NidhiLohana/RocketTeam/RU First Prototype/STM 32 RU First Prototype.kicad_pcb

## KiCad design RU First Prototype/STM 32 RU First Prototype.kicad_pcb (2026-11-07)

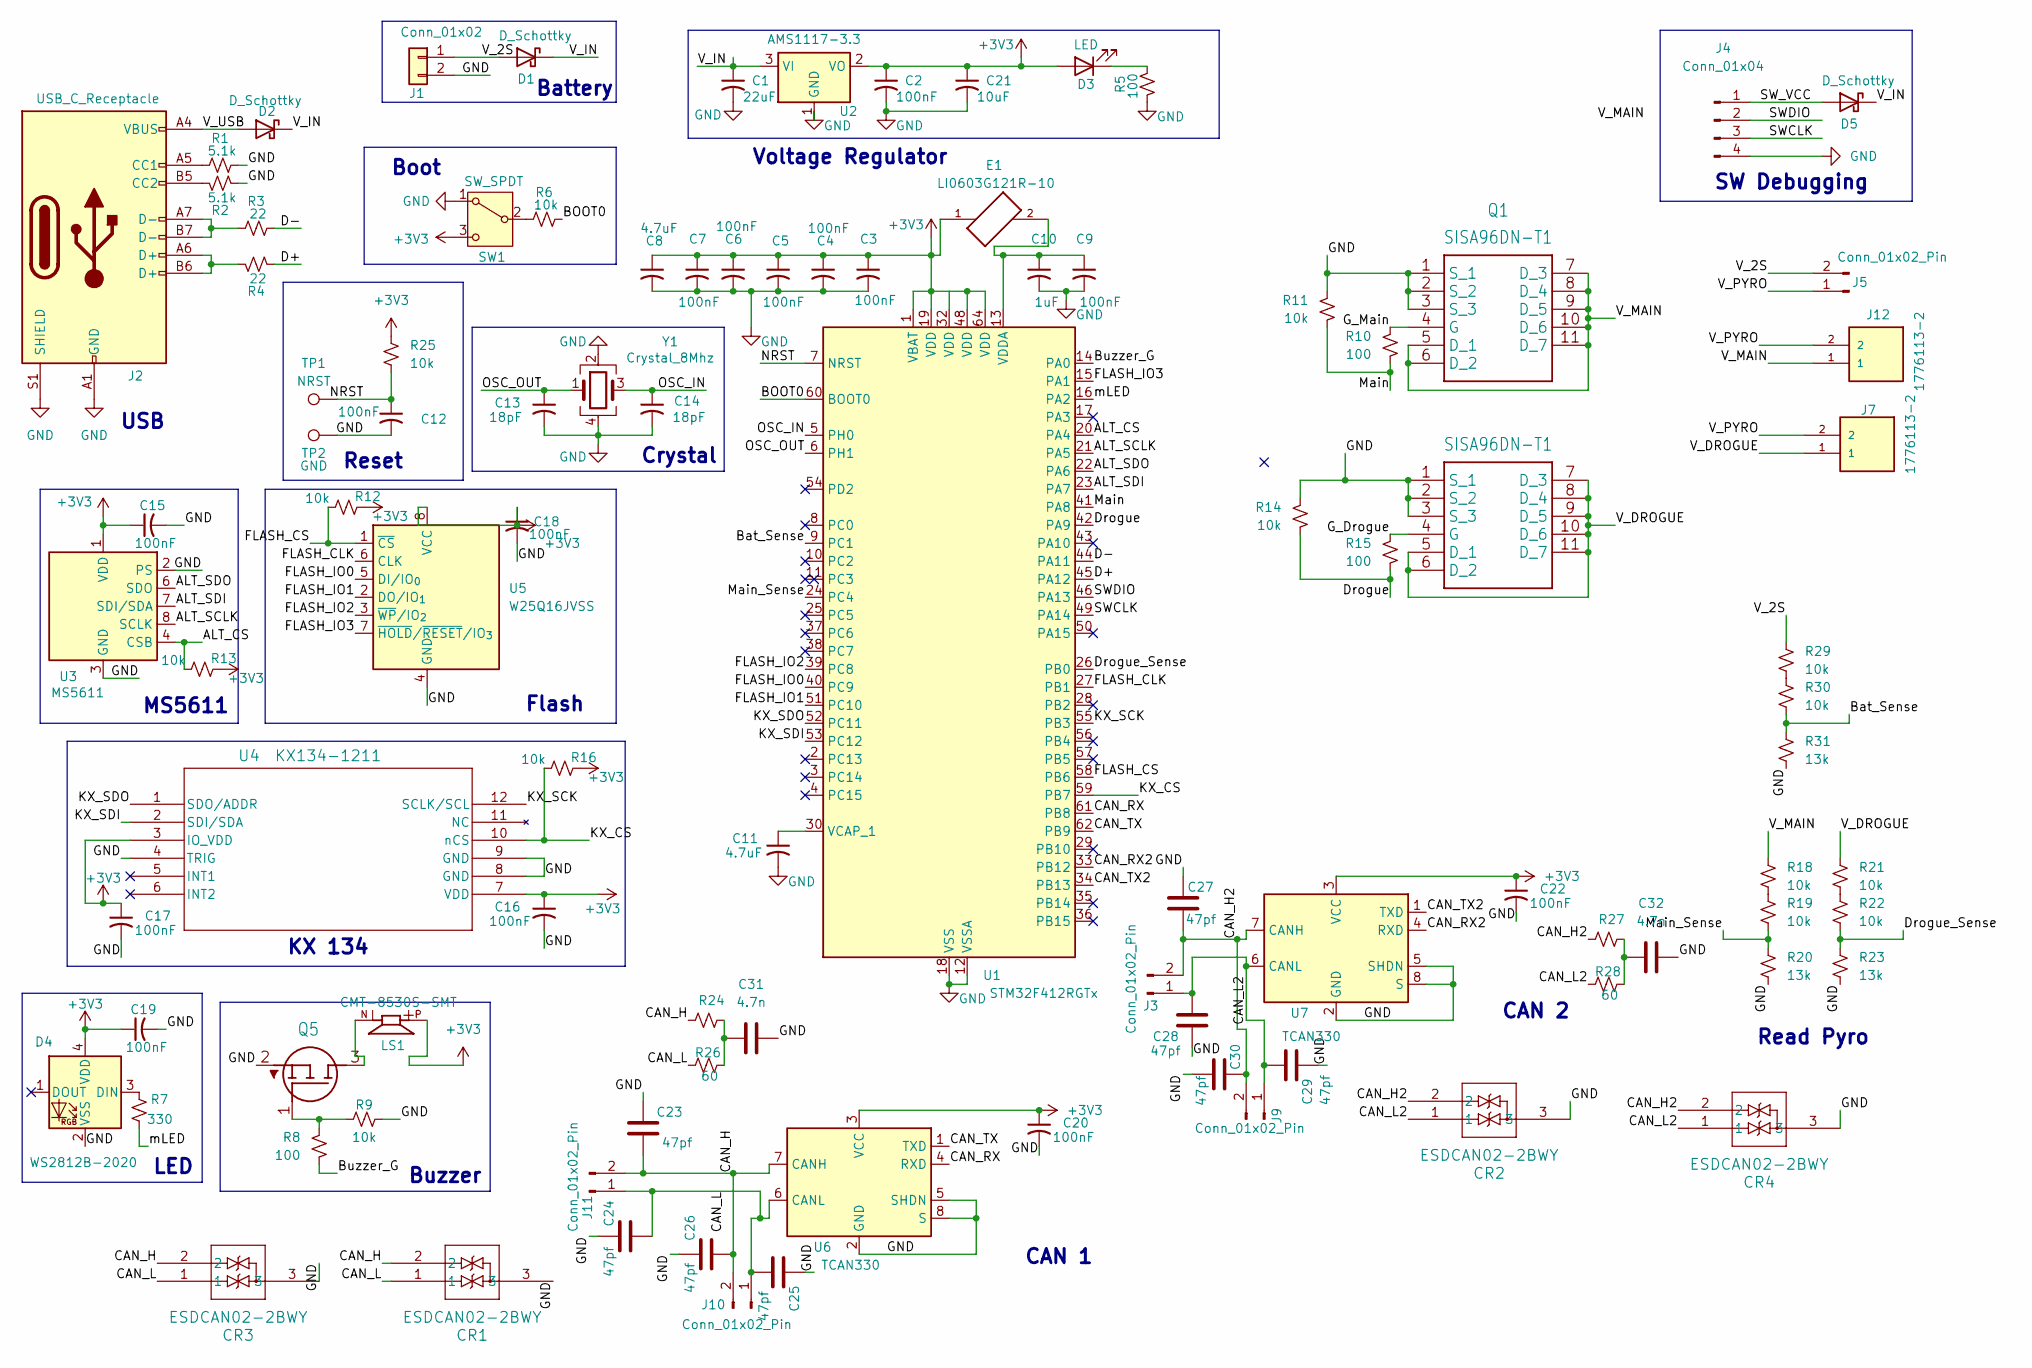
[picture p1: schematic STM 32 RU First Prototype.kicad_sch]

Parts:
C1: 22uF; C_0603_1608Metric
C2, C3, C4, C5, C6, C7, C9, C12, C15, C16, C17, C18, C19, C20, C22: 100nF; C_0603_1608Metric
C8, C11: 4.7uF; C_0603_1608Metric
C10: 1uF; C_0603_1608Metric
C13, C14: 18pF; C_0603_1608Metric
C21: 10uF; C_0603_1608Metric
C23, C24, C25, C26, C27, C28, C29, C30: 47pf; C_0603_1608Metric
C31, C32: 4.7n; C_0603_1608Metric
CR1, CR2, CR3, CR4: ESDCAN02-2BWY; SOT323-3L_STM
D1, D2, D5: D_Schottky; D_SOD-128
D3: LED; D_0603_1608Metric
D4: WS2812B-2020; LED_WS2812B-2020_PLCC4_2.0x2.0mm
E1: LI0603G121R-10; FB_LI0603G121R-10; PARTREV C
J1: Conn_01x02; AMASS_XT30U-M_1x02_P5.0mm_Vertical
J2: USB_C_Receptacle; USB_C_Receptacle_GCT_USB4105-xx-A_16P_TopMnt_Horizontal
J3, J9, J10, J11: Conn_01x02_Pin; JST_EH_B2B-EH-A_1x02_P2.50mm_Vertical
J4: Conn_01x04; PinHeader_1x04_P2.54mm_Vertical
J5: Conn_01x02_Pin; AMASS_XT30U-M_1x02_P5.0mm_Vertical
J7, J12: 1776113-2; TE_1776113-2; PART_REV P
LS1: CMT-8530S-SMT; CUI_CMT-8530S-SMT
Q1, Q3: SISA96DN-T1; SIS862DNT1GE3
Q5: SOT95P240X115-3N
R1, R2: 5.1k; R_0603_1608Metric
R3, R4: 22; R_0603_1608Metric
R5, R8, R10, R15: 100; R_0603_1608Metric
R6, R9, R11, R12, R13, R14, R16, R18, R19, R21, R22, R25, R29, R30: 10k; R_0603_1608Metric
R7: 330; R_0603_1608Metric
R20, R23, R31: 13k; R_0603_1608Metric
R24, R26, R27, R28: 60; R_0603_1608Metric
SW1: SW_SPDT; SW_SPDT_PCM12
TP1: NRST; TestPoint_Pad_2.0x2.0mm
TP2: GND; TestPoint_Pad_2.0x2.0mm
U1: STM32F412RGTx; LQFP-64_10x10mm_P0.5mm
U2: AMS1117-3.3; SOT-223-3_TabPin2
U3: MS5611; LGA-8_3x5mm_P1.25mm
U4: KX134-1211; XDCR_KX003-1077
U5: W25Q16JVSS; SOIC-8_5.3x5.3mm_P1.27mm
U6, U7: TCAN330; SOIC-8_3.9x4.9mm_P1.27mm
Y1: Crystal_8Mhz; Crystal_SMD_7050-4Pin_7.0x5.0mm

Connections:
+3V3: C2.1, C3.1, C4.1, C5.1, C6.1, C7.1, C8.1, C15.1, C16.1, C17.1, C18.1, C19.1, C20.1, C21.1, C22.1, D3.2 (A), D4.4 (VDD), E1.1, LS1.P, R12.2, R13.2, R16.2, R25.1, SW1.3 (C), U1.1 (VBAT), U1.19 (VDD), U1.32 (VDD), U1.48 (VDD), U1.64 (VDD), U2.2 (VO), U3.1 (VDD), U4.3 (IO_VDD), U4.7 (VDD), U5.8 (VCC), U6.3 (VCC), U7.3 (VCC)
/ALT_CS: R13.1, U1.20 (PA4), U3.4 (CSB), U3.5 (CSB)
/ALT_SCLK: U1.21 (PA5), U3.8 (SCLK)
/ALT_SDI: U1.23 (PA7), U3.7 (SDI/SDA)
/ALT_SDO: U1.22 (PA6), U3.6 (SDO)
/BOOT0: R6.2, U1.60 (BOOT0)
/Bat_Sense: R30.2, R31.1, U1.9 (PC1)
/Buzzer_G: R8.2, U1.14 (PA0)
/CAN_H: C23.2, C26.2, CR1.2, CR3.2, J10.2, J11.2, R24.1, U6.7 (CANH)
/CAN_H2: C27.2, C30.2, CR2.2, CR4.2, J3.2, J9.2, R27.1, U7.7 (CANH)
/CAN_L: C24.2, C25.2, CR1.1, CR3.1, J10.1, J11.1, R26.1, U6.6 (CANL)
/CAN_L2: C28.2, C29.2, CR2.1, CR4.1, J3.1, J9.1, R28.1, U7.6 (CANL)
/CAN_RX: U1.61 (PB8), U6.4 (RXD)
/CAN_RX2: U1.33 (PB12), U7.4 (RXD)
/CAN_TX: U1.62 (PB9), U6.1 (TXD)
/CAN_TX2: U1.34 (PB13), U7.1 (TXD)
/D+: R4.2, U1.45 (PA12)
/D-: R3.2, U1.44 (PA11)
/Drogue: R14.2, R15.2, U1.42 (PA9)
/Drogue_Sense: R22.2, R23.1, U1.26 (PB0)
/FLASH_CLK: U1.27 (PB1), U5.6 (CLK)
/FLASH_CS: R12.1, U1.58 (PB6), U5.1 (~CS)
/FLASH_IO0: U1.40 (PC9), U5.5 (DI/IO_{0})
/FLASH_IO1: U1.51 (PC10), U5.2 (DO/IO_{1})
/FLASH_IO2: U1.39 (PC8), U5.3 (~WP/IO_{2})
/FLASH_IO3: U1.15 (PA1), U5.7 (~HOLD/~RESET/IO_{3})
/G_Drogue: Q3.4 (G), R15.1
/G_Main: Q1.4 (G), R10.1
/KX_CS: R16.1, U1.59 (PB7), U4.10 (nCS)
/KX_SCK: U1.55 (PB3), U4.12 (SCLK/SCL)
/KX_SDI: U1.53 (PC12), U4.2 (SDI/SDA)
/KX_SDO: U1.52 (PC11), U4.1 (SDO/ADDR)
/Main: R10.2, R11.2, U1.41 (PA8)
/Main_Sense: R19.2, R20.1, U1.24 (PC4)
/NRST: C12.1, R25.2, TP1.1 (1_1), U1.7 (NRST)
/OSC_IN: C14.1, U1.5 (PH0), Y1.3
/OSC_OUT: C13.1, U1.6 (PH1), Y1.1
/SWCLK: J4.3, U1.49 (PA14)
/SWDIO: J4.2, U1.46 (PA13)
/SW_VCC: D5.2 (A), J4.1
/V_2S: D1.2 (A), J1.1, J5.2, R29.1
/V_DROGUE: J7.1, Q3.5 (D_1), Q3.6 (D_2), Q3.7 (D_3), Q3.8 (D_4), Q3.9 (D_5), Q3.10 (D_6), Q3.11 (D_7), R21.1
/V_IN: C1.1, D1.1 (K), D2.1 (K), D5.1 (K), U2.3 (VI)
/V_MAIN: J12.1, Q1.5 (D_1), Q1.6 (D_2), Q1.7 (D_3), Q1.8 (D_4), Q1.9 (D_5), Q1.10 (D_6), Q1.11 (D_7), R18.1
/V_PYRO: J5.1, J7.2, J12.2
/V_USB: D2.2 (A), J2.A4 (VBUS), J2.A9 (VBUS), J2.B4 (VBUS), J2.B9 (VBUS)
/mLED: R7.2, U1.16 (PA2)
GND: C1.2, C2.2, C3.2, C4.2, C5.2, C6.2, C7.2, C8.2, C9.2, C10.2, C11.2, C12.2, C13.2, C14.2, C15.2, C16.2, C17.2, C18.2, C19.2, C20.2, C21.2, C22.2, C23.1, C24.1, C25.1, C26.1, C27.1, C28.1, C29.1, C30.1, C31.2, C32.2, CR1.3, CR2.3, CR3.3, CR4.3, D4.2 (VSS), J1.2, J2.A1 (GND), J2.A12 (GND), J2.B1 (GND), J2.B12 (GND), J2.S1 (SHIELD), J4.4, Q1.1 (S_1), Q1.2 (S_2), Q1.3 (S_3), Q3.1 (S_1), Q3.2 (S_2), Q3.3 (S_3), Q5.2 (S), R1.2, R2.2, R5.2, R9.1, R11.1, R14.1, R20.2, R23.2, R31.2, SW1.1 (A), TP2.1 (1_1), U1.12 (VSSA), U1.18 (VSS), U1.31 (VSS), U1.47 (VSS), U1.63 (VSS), U2.1 (GND), U3.2 (PS), U3.3 (GND), U4.4 (TRIG), U4.8 (GND), U4.9 (GND), U5.4 (GND), U6.2 (GND), U6.5 (SHDN), U6.8 (S), U7.2 (GND), U7.5 (SHDN), U7.8 (S), Y1.2, Y1.4
unnamed: C31.1, R24.2, R26.2
unnamed: C32.1, R27.2, R28.2
unnamed: D3.1 (K), R5.1
unnamed: D4.3 (DIN), R7.1
unnamed: J2.A5 (CC1), R1.1
unnamed: J2.B5 (CC2), R2.1
unnamed: J2.A6 (D+), J2.B6 (D+), R4.1
unnamed: J2.A7 (D-), J2.B7 (D-), R3.1
unnamed: LS1.N, Q5.3 (D)
unnamed: Q5.1 (G), R8.1, R9.2
unnamed: R18.2, R19.1
unnamed: R21.2, R22.1
unnamed: R29.2, R30.1
unnamed: R6.1, SW1.2 (B)
unnamed: C11.1, U1.30 (VCAP_1)
unnamed: C9.1, C10.1, E1.2, U1.13 (VDDA)

Notes on the sheet:
Flash
Voltage Regulator
Buzzer
LED
Battery
Reset
USB
MS5611
CAN 1
Boot
SW Debugging
CAN 2
KX 134
Read Pyro
Crystal

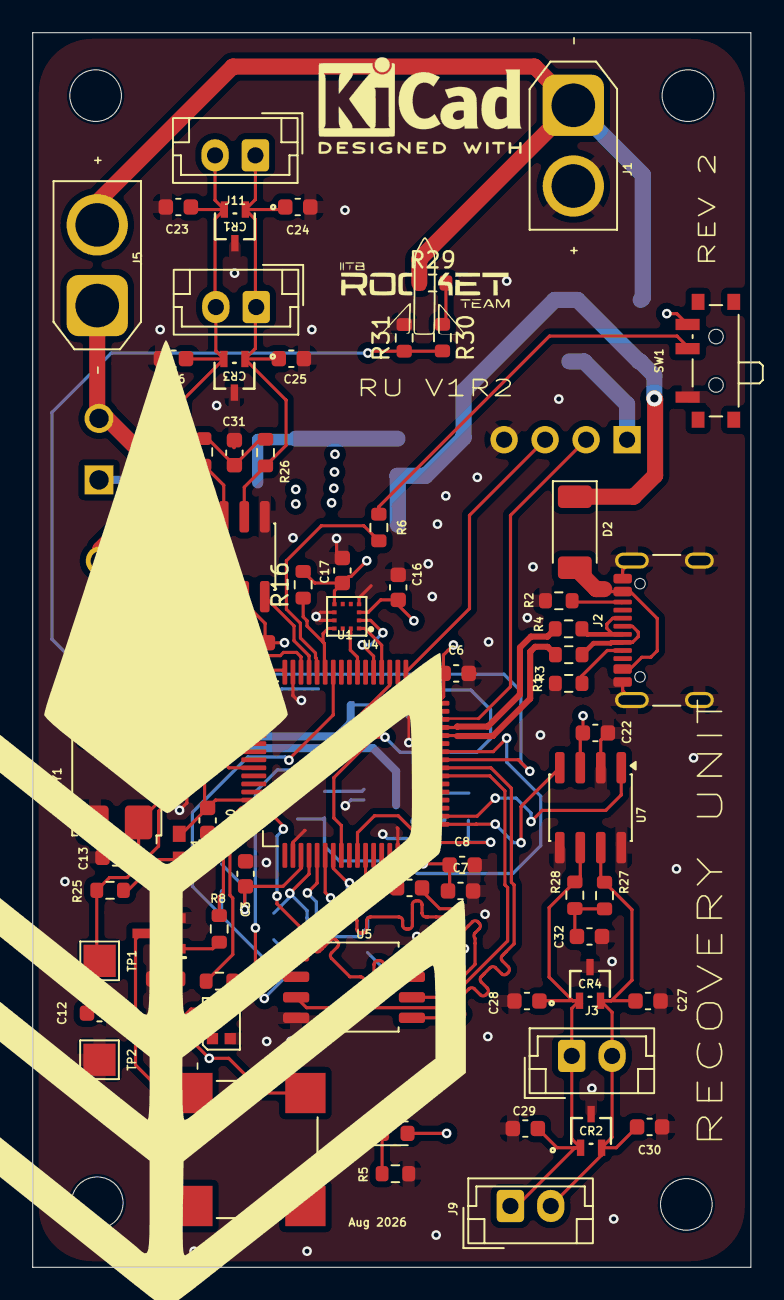
[picture p2: board STM 32 RU First Prototype.kicad_pcb from above]

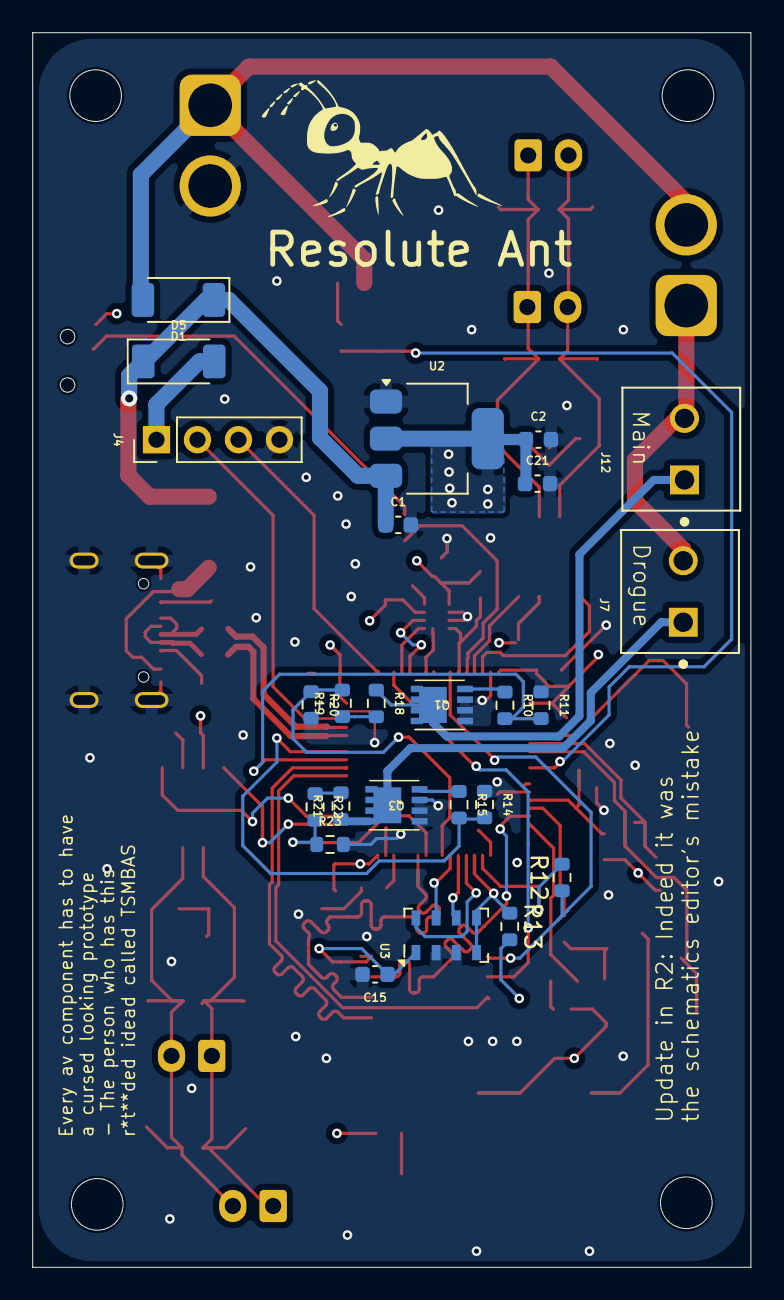
[picture p3: board STM 32 RU First Prototype.kicad_pcb from below]

Board: 4 copper layers, 44.5 x 76.5 mm, 97 parts (25 on the bottom side), 64 nets.
