NidhiLohana/RocketTeam/(commit log)

2026-08-01 Add initial README for RU First Prototype
2026-08-01 First schematic commit
    [STM 32 RU First Prototype.kicad_sch]
2026-08-09 Schematic adjusted for symbols and footprint assignments, and I2C replaced with SPI
    [STM 32 RU First Prototype.kicad_sch]
2026-08-09 Added missing footprints
    [STM 32 RU First Prototype.kicad_pcb, STM 32 RU First Prototype.kicad_sch]
2026-08-24 Added 4 layer parameters
    [STM 32 RU First Prototype.kicad_pcb]
2026-08-26 Intermediate circuits of CAN, USB left, Spatial arrangement left
    [STM 32 RU First Prototype.kicad_pcb, STM 32 RU First Prototype.kicad_sch]
2026-08-28 Started Laying traces
    [STM 32 RU First Prototype.kicad_pcb, STM 32 RU First Prototype.kicad_sch]
2026-08-29 Added some more traces
    [STM 32 RU First Prototype.kicad_pcb, STM 32 RU First Prototype.kicad_sch]
2026-08-30 Changing XT30 connectors left
    [STM 32 RU First Prototype.kicad_pcb, STM 32 RU First Prototype.kicad_sch]
2026-08-30 Routing Round One done
    [STM 32 RU First Prototype.kicad_pcb]
2026-09-03 Compactness ++
    [STM 32 RU First Prototype.kicad_pcb, STM 32 RU First Prototype.kicad_sch]
2026-09-04 Edge cuts to start
    [STM 32 RU First Prototype.kicad_pcb, STM 32 RU First Prototype.kicad_sch]
2026-09-06 Added fill zones and all
    [STM 32 RU First Prototype.kicad_pcb]
2026-09-06 Made some changes
    [STM 32 RU First Prototype.kicad_pcb]
2026-09-06 made some changes to routings
    [STM 32 RU First Prototype.kicad_pcb]
2026-09-07 made some more changes
    [STM 32 RU First Prototype.kicad_pcb, STM 32 RU First Prototype.kicad_sch]
2026-09-07 changed CAN xt30 to jst 2.5
    [STM 32 RU First Prototype.kicad_pcb, STM 32 RU First Prototype.kicad_sch]
2026-09-07 edge cuts adjustments
    [STM 32 RU First Prototype.kicad_pcb]
2026-09-07 Final touch done from my side
    [STM 32 Custom Board.kicad_sch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]
2026-10-28 Fixed schematic and some routing, flash routing left
2026-10-28 Added flash chip and CAN bus 2 connections
2026-10-31 Fixed SDO-SDI, Added Battery monitoring, and ADC inputs
2026-11-07 changed revision name in silkscreen
